carlosoliveirajesus/blackpill_nano/hw/Bibliotecas/LIB_ABS04W-32.768KHZ-6-D2-T5/ABS04W-32.768KHZ-6-D2-T5/3D/ABS04W-32.768KHZ-6-D2-T5.stp

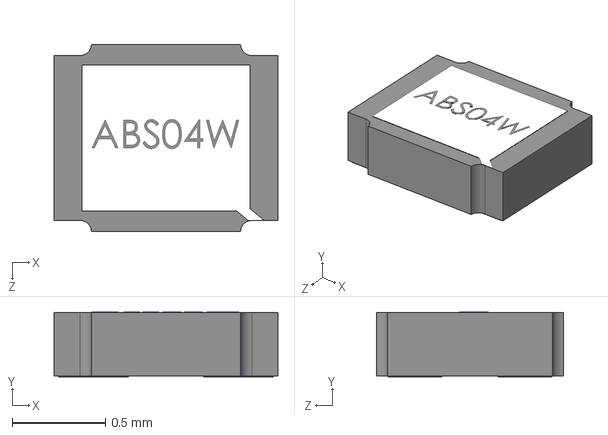
[picture p1: CAD file, 2026-09-24]
hw/Bibliotecas/LIB_ABS04W-32.768KHZ-6-D2-T5/ABS04W-32.768KHZ-6-D2-T5/3D/ABS04W-32.768KHZ-6-D2-T5.stp
1.20 x 0.347 x 1.00 mm
