carlosoliveirajesus/blackpill_nano/(list of files, cad)

Other CAD files:
hw/Bibliotecas/LIB_ABS04W-32.768KHZ-6-D2-T5/ABS04W-32.768KHZ-6-D2-T5/Allegro/abs04w32768khz6d2t5.psm
hw/Bibliotecas/LIB_ABS04W-32.768KHZ-6-D2-T5/ABS04W-32.768KHZ-6-D2-T5/DEHDL/abs04w_32.768khz_6_d2_t5/chips/chips.prt
