carlosoliveirajesus/blackpill_nano/(list of files, drawings)

Other design files:
hw/Bibliotecas/LIB_ABS04W-32.768KHZ-6-D2-T5/ABS04W-32.768KHZ-6-D2-T5/Altium/ABS04W32768KHZ6D2T5.PcbLib
hw/Bibliotecas/LIB_ABS04W-32.768KHZ-6-D2-T5/ABS04W-32.768KHZ-6-D2-T5/Altium/ABS04W-32.768KHZ-6-D2-T5.SchLib
