carlosoliveirajesus/blackpill_nano/hw/Blackpill_STM32L432KC/stm32l432kc/stm32l432kc.kicad_pcb

## KiCad design hw/Blackpill_STM32L432KC/stm32l432kc/stm32l432kc.kicad_pcb (2026-09-24)

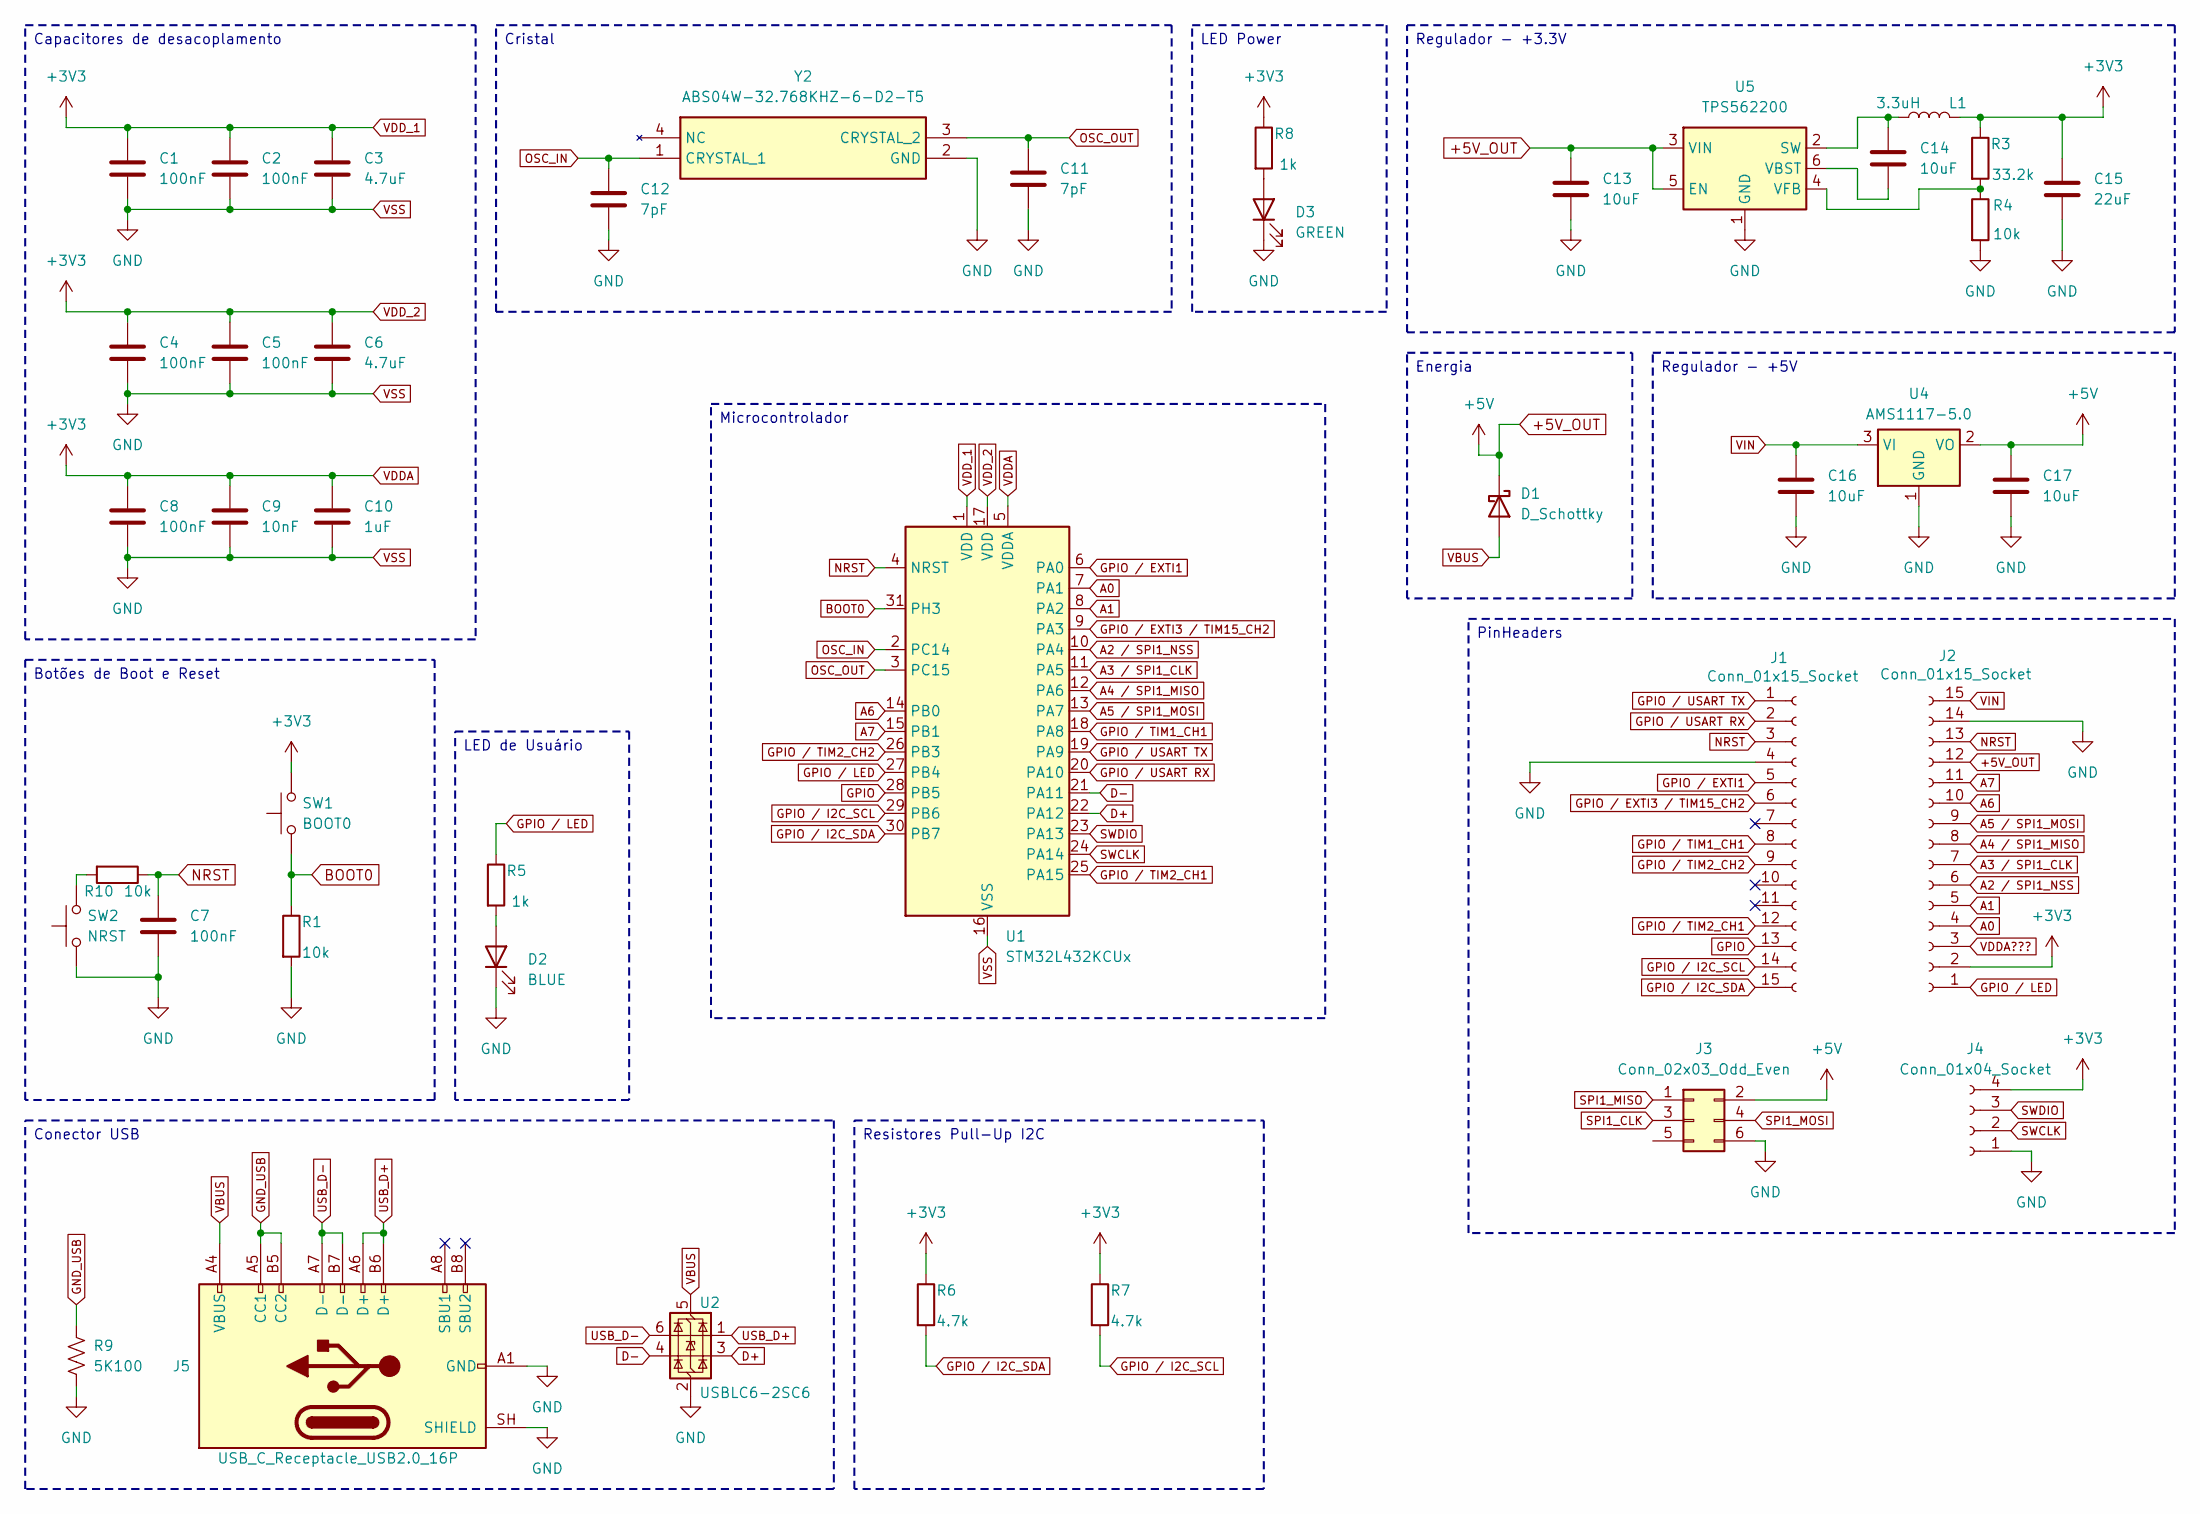
[picture p2: schematic stm32l432kc.kicad_sch]

Parts:
C1, C2, C4, C5, C7, C8: 100nF; C_0402_1005Metric
C3, C6: 4.7uF; C_0402_1005Metric
C9: 10nF; C_0402_1005Metric
C10: 1uF; C_0402_1005Metric
C11, C12: 7pF; C_0201_0603Metric
C13, C14, C16, C17: 10uF; C_0402_1005Metric
C15: 22uF; C_0201_0603Metric
D1: D_Schottky; D_SOD-123
D2: BLUE; LED_0603_1608Metric
D3: GREEN; LED_0603_1608Metric
J1, J2: Conn_01x15_Socket; PinHeader_1x15_P2.54mm_Vertical
J3: Conn_02x03_Odd_Even; PinHeader_2x03_P2.54mm_Vertical
J4: Conn_01x04_Socket; PinHeader_1x04_P2.54mm_Horizontal
J5: USB_C_Receptacle_USB2.0_16P; USB_C_Receptacle_GCT_USB4105-xx-A_16P_TopMnt_Horizontal
L1: 3.3uH; L_0603_1608Metric
R1, R4, R10: 10k; R_0402_1005Metric
R3: 33.2k; R_0402_1005Metric
R5, R8: 1k; R_0402_1005Metric
R6, R7: 4.7k; R_01005_0402Metric
R9: 5K100; R_0603_1608Metric_Pad0.98x0.95mm_HandSolder
SW1: BOOT0; SW_SPST_B3U-1000P
SW2: NRST; SW_SPST_B3U-1000P
U1: STM32L432KCUx; QFN-32-1EP_5x5mm_P0.5mm_EP3.45x3.45mm
U2: USBLC6-2SC6; SOT-23-6
U4: AMS1117-5.0; SOT-223-3_TabPin2
U5: TPS562200; SOT-23-6
Y2: ABS04W-32.768KHZ-6-D2-T5; ABS04W32768KHZ6D2T5; Mouser Part Number 815-04W-32.768-6-D2T

Connections:
+5V_OUT: C13.1, C17.1, D1.1 (K), J2.12, J3.2, U4.2 (VO), U5.3 (VIN), U5.5 (EN)
A0: J2.4, U1.7 (PA1)
A1: J2.5, U1.8 (PA2)
A2 / SPI1_NSS: J2.6, U1.10 (PA4)
A3 / SPI1_CLK: J2.7, U1.11 (PA5)
A4 / SPI1_MISO: J2.8, U1.12 (PA6)
A5 / SPI1_MOSI: J2.9, U1.13 (PA7)
A6: J2.10, U1.14 (PB0)
A7: J2.11, U1.15 (PB1)
BOOT0: R1.1, SW1.1, U1.31 (PH3)
D+: U1.22 (PA12), U2.3 (I/O2)
D-: U1.21 (PA11), U2.4 (I/O2)
GND_USB: J5.A5 (CC1), J5.B5 (CC2), R9.1
GPIO: J1.13, U1.28 (PB5)
GPIO / EXTI1: J1.5, U1.6 (PA0)
GPIO / EXTI3 / TIM15_CH2: J1.6, U1.9 (PA3)
GPIO / I2C_SCL: J1.14, R7.2, U1.29 (PB6)
GPIO / I2C_SDA: J1.15, R6.2, U1.30 (PB7)
GPIO / LED: J2.1, R5.1, U1.27 (PB4)
GPIO / TIM1_CH1: J1.8, U1.18 (PA8)
GPIO / TIM2_CH1: J1.12, U1.25 (PA15)
GPIO / TIM2_CH2: J1.9, U1.26 (PB3)
GPIO / USART RX: J1.2, U1.20 (PA10)
GPIO / USART TX: J1.1, U1.19 (PA9)
NRST: C7.1, J1.3, J2.13, R10.1, U1.4 (NRST); also elsewhere on the board
unnamed: D2.2 (A), R5.2
unnamed: D3.2 (A), R8.2
unnamed: R10.2, SW2.2
unnamed: C14.1, L1.2, U5.2 (SW)
unnamed: C14.2, U5.6 (VBST)
unnamed: R3.2, R4.1, U5.4 (VFB)
OSC_IN: C12.1, U1.2 (PC14), Y2.1 (CRYSTAL_1)
OSC_OUT: C11.1, U1.3 (PC15), Y2.3 (CRYSTAL_2)
SPI1_CLK: J3.3
SPI1_MISO: J3.1
SPI1_MOSI: J3.4
SWCLK: J4.2, U1.24 (PA14)
SWDIO: J4.3, U1.23 (PA13)
USB_D+: J5.A6 (D+), J5.B6 (D+), U2.1 (I/O1)
USB_D-: J5.A7 (D-), J5.B7 (D-), U2.6 (I/O1)
VBUS: D1.2 (A), J5.A4 (VBUS), J5.A9 (VBUS), J5.B4 (VBUS), J5.B9 (VBUS), U2.5 (VBUS)
VDDA: C1.1, C2.1, C3.1, C4.1, C5.1, C6.1, C8.1, C9.1, C10.1, C15.1, J2.2, J4.4, L1.1, R3.1, R6.1, R7.1, R8.1, SW1.2, U1.1 (VDD), U1.5 (VDDA), U1.17 (VDD); also elsewhere on the board
VDDA???: J2.3
VIN: C16.1, J2.15, U4.3 (VI)
VSS: C1.2, C2.2, C3.2, C4.2, C5.2, C6.2, C7.2, C8.2, C9.2, C10.2, C11.2, C12.2, C13.2, C15.2, C16.2, C17.2, D2.1 (K), D3.1 (K), J1.4, J2.14, J3.6, J4.1, J5.A1 (GND), J5.A12 (GND), J5.B1 (GND), J5.B12 (GND), J5.SH (SHIELD), R1.2, R4.2, R9.2, SW2.1, U1.16 (VSS), U1.32 (VSS), U1.33 (VSS), U2.2 (GND), U4.1 (GND), U5.1 (GND), Y2.2 (GND)

Notes on the sheet:
LED de Usuário
Energia
Capacitores de desacoplamento
Regulador - +5V
PinHeaders
Conector USB
Resistores Pull-Up I2C
LED Power
Regulador - +3.3V
Botões de Boot e Reset
Microcontrolador
Cristal

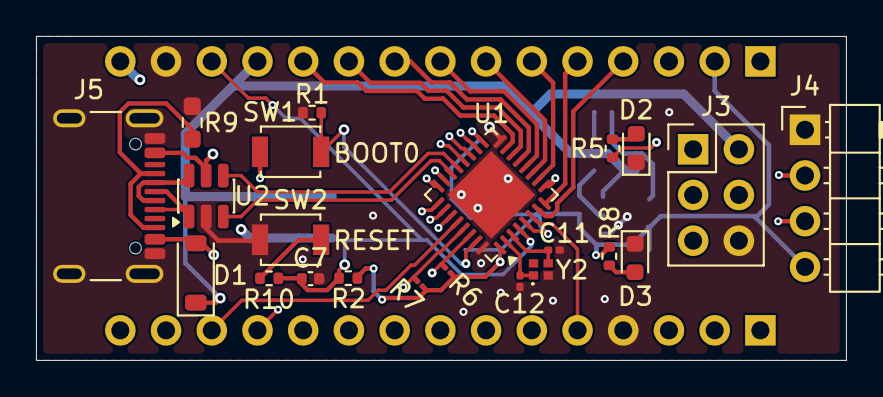
[picture p3: board stm32l432kc.kicad_pcb from above]

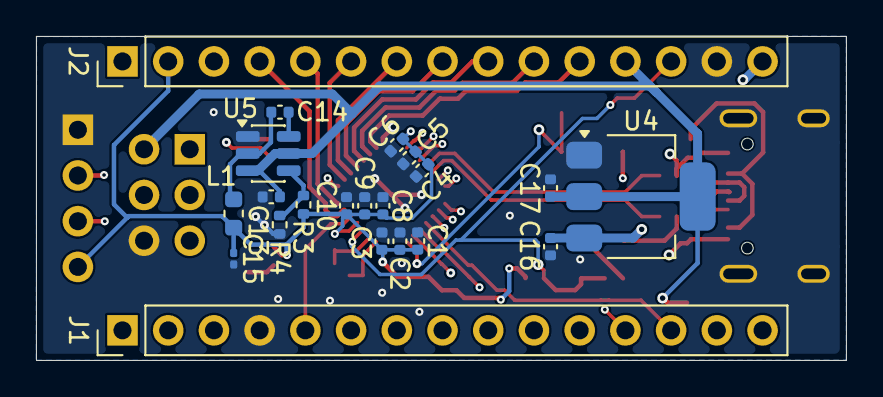
[picture p4: board stm32l432kc.kicad_pcb from below]

Board: 4 copper layers, 45.0 x 18.0 mm, 43 parts (21 on the bottom side), 41 nets.

Other parts of the board:
R2: 10k; R_0402_1005Metric

Their connections:
NRST: R2.2; also elsewhere on the board
VDDA: R2.1; also elsewhere on the board
