carlosoliveirajesus/blackpill_nano/fw/STM32L432KCx/STM32L432KCx/STM32L432KCx.ioc

Mcu.UserName=STM32L432KCUx
PA0.Signal=GPIO_Output
PA1.Signal=ADCx_IN6
PA10.Signal=USART1_RX
PA11.Signal=USB_DM
PA12.Signal=USB_DP
PA2.Signal=ADCx_IN7
PA3.Signal=S_TIM15_CH2
PA4.Signal=SPI1_NSS
PA5.Signal=SPI1_SCK
PA6.Signal=SPI1_MISO
PA7.Signal=SPI1_MOSI
PA8.Signal=S_TIM1_CH1
PA9.Signal=USART1_TX
PB0.Signal=ADCx_IN15
PB1.Signal=ADCx_IN16
PB5.Signal=GPIO_Output
PB6.Signal=I2C1_SCL
PB7.Signal=I2C1_SDA
PH3-BOOT0.GPIO_Label=BOOT0
PH3-BOOT0.Signal=GPIO_Input
